mirunaandreea1212/Handmade-Anemometer-Calibration/README.md

Developed a simple experimental setup using basic materials in a device fabrication laboratory and analyzed collected data using fundamental physics principles.
IR Object Detection System (Arduino): Implemented real-time object detection using an infrared reflective sensor and LED feedback.
Anemometer Speed Measurement System (Arduino): Developed an interrupt-based rotation counter to measure RPM and wind speed using an IR sensor.
